Kampi/ZigBee-LightSensor/project/BeeLight.kicad_pcb

## KiCad design project/BeeLight.kicad_pcb (2025-01-14)

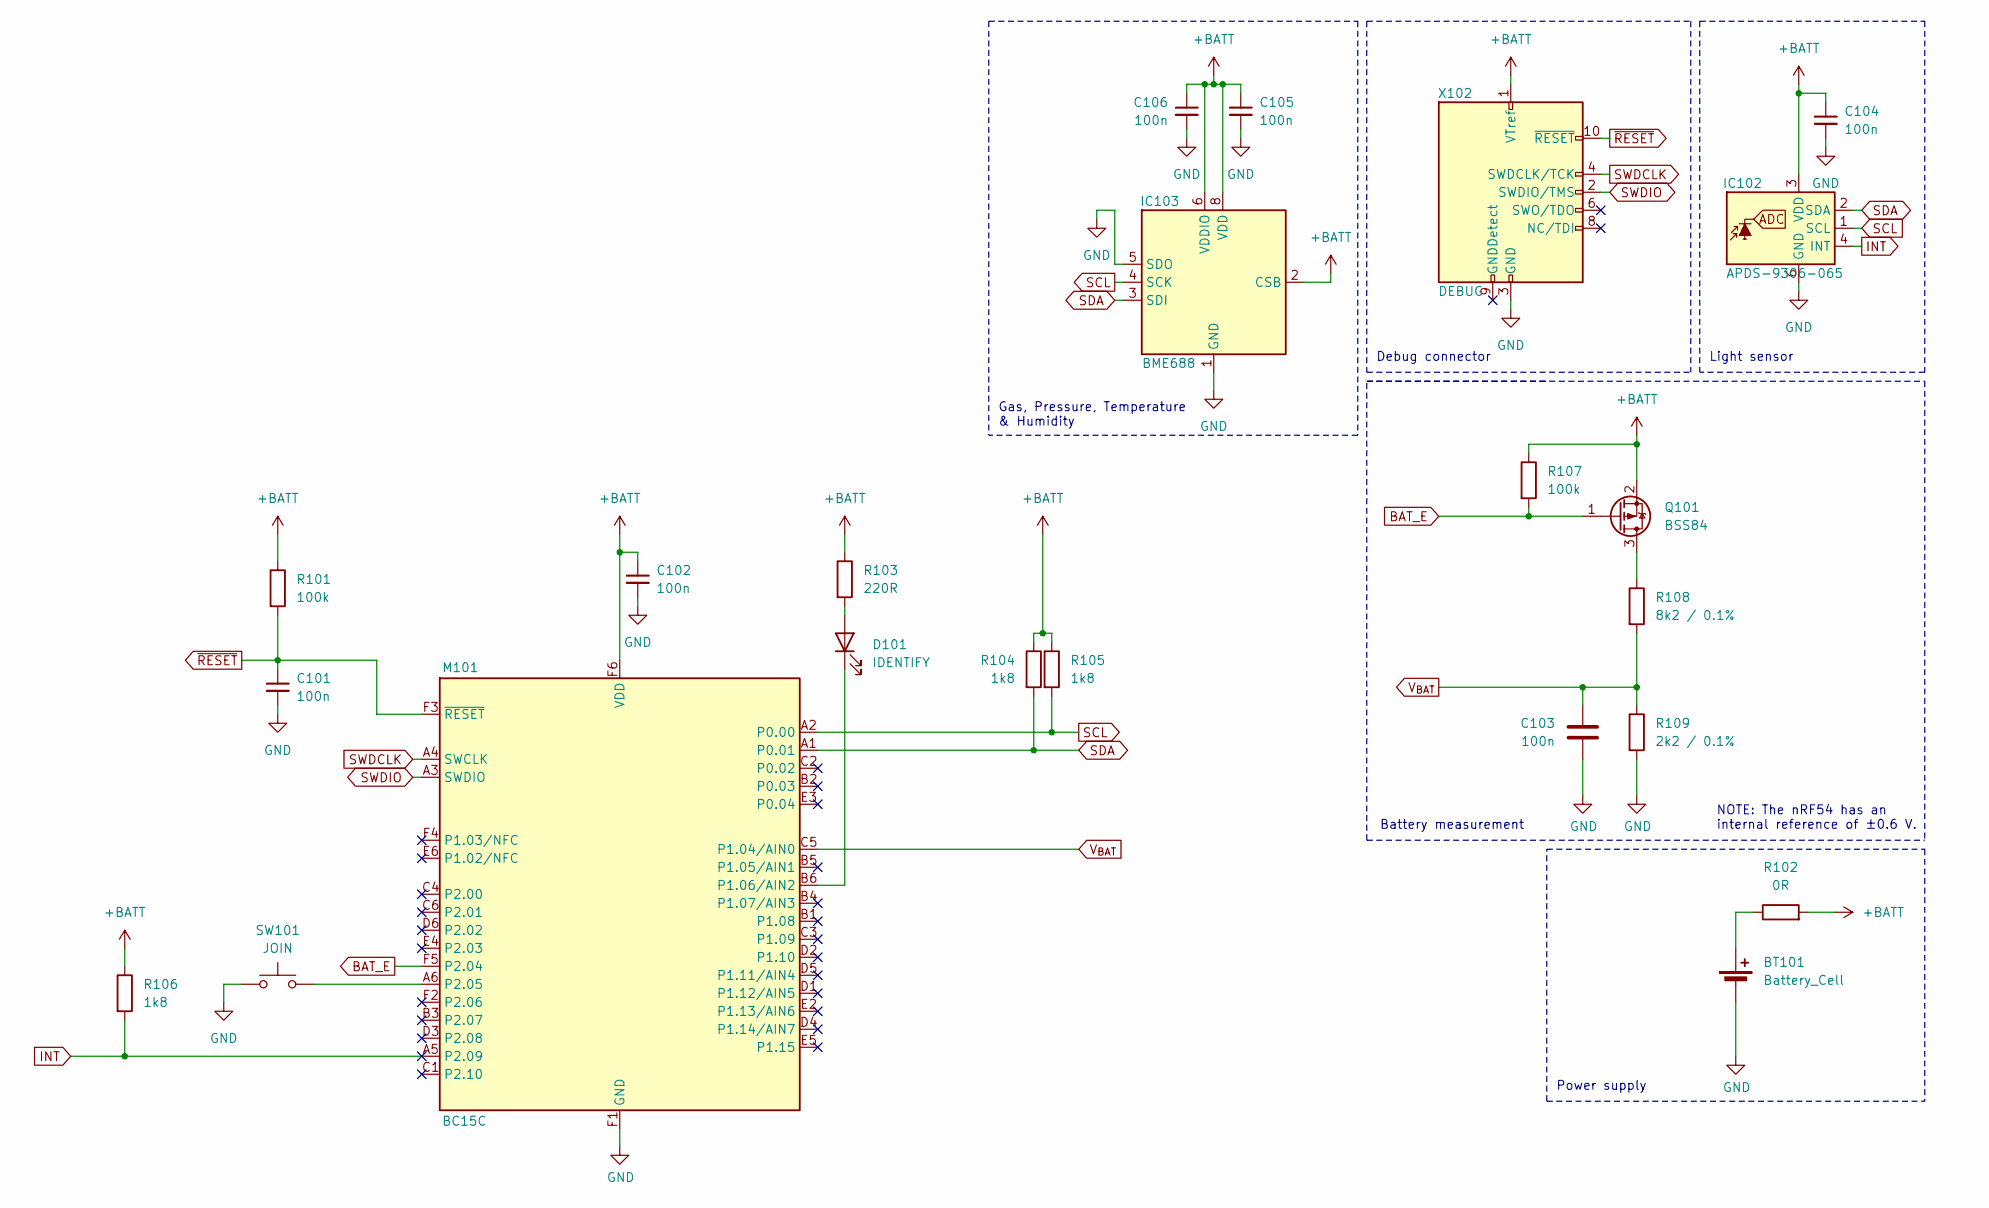
[picture p1: schematic BeeLight.kicad_sch]

Parts:
BT101: Battery_Cell; 3002; mouser# 534-3002
C101, C102, C103, C104, C105, C106: 100n; C_0402_1005Metric_Pad0.74x0.62mm_HandSolder; mouser# 581-04025C104KAT4A
D101: IDENTIFY; LED_0805_2012Metric_Pad1.15x1.40mm_HandSolder; mouser# 630-HSMQ-C170-T0000
IC102: APDS-9306-065; Broadcom_DFN-6_2x2mm_P0.65mm; mouser# 630-APDS-9306-065
IC103: BME688; Bosch_LGA-8_3x3mm_P0.8mm_ClockwisePinNumbering; mouser# 262-BME688
M101: BC15C; mouser# 308-BM15C
Q101: BSS84; SOT-23-3; mouser# 512-BSS84
R101, R107: 100k; R_0402_1005Metric_Pad0.72x0.64mm_HandSolder; mouser# 603-RC0402FR-07100KL
R102: 0R; R_0805_2012Metric_Pad1.20x1.40mm_HandSolder; mouser# 652-CR0805AJ/-000EAS
R103: 220R; R_0402_1005Metric_Pad0.72x0.64mm_HandSolder; mouser# 652-CR0402-JW-221GLF
R104, R105, R106: 1k8; R_0402_1005Metric_Pad0.72x0.64mm_HandSolder; mouser# 603-RC0402FR-071K8L
R108: 8k2 / 0.1%; R_0402_1005Metric_Pad0.72x0.64mm_HandSolder; mouser# 603-RT0402BRD078K2L
R109: 2k2 / 0.1%; R_0402_1005Metric_Pad0.72x0.64mm_HandSolder; mouser# 603-RT0402BRD072K2L
SW101: JOIN; WS-TASV-6x6; mouser# 710-430182095816
X102: DEBUG; PinHeader_2x05_P1.27mm_Vertical; mouser# 200-SHF-105-01-L-D-TH-TR

Connections:
+BATT: C102.1, C104.1, C105.1, C106.1, IC102.3 (VDD), IC103.2 (CSB), IC103.6 (VDDIO), IC103.8 (VDD), M101.F6 (VDD), Q101.2 (S), R101.1, R102.2, R103.1, R104.1, R105.1, R106.1, R107.1, X102.1 (VTref)
BAT_E: M101.F5 (P2.04), Q101.1 (G), R107.2
GND: BT101.2 (-), C101.2, C102.2, C103.2, C104.2, C105.2, C106.2, IC102.6 (GND), IC103.1 (GND), IC103.5 (SDO), IC103.7 (GND), M101.E1 (GND), M101.F1 (GND), R109.2, SW101.1, X102.3 (GND), X102.5 (GND)
INT: IC102.4 (INT), M101.A5 (P2.09), R106.2
unnamed: BT101.1 (+), R102.1
unnamed: D101.2 (A), R103.2
unnamed: D101.1 (K), M101.B6 (P1.06/AIN2)
unnamed: M101.A6 (P2.05), SW101.2
unnamed: Q101.3 (D), R108.1
SCL: IC102.1 (SCL), IC103.4 (SCK), M101.A2 (P0.00), R105.2
SDA: IC102.2 (SDA), IC103.3 (SDI), M101.A1 (P0.01), R104.2
SWDCLK: M101.A4 (SWCLK), X102.4 (SWDCLK/TCK)
SWDIO: M101.A3 (SWDIO), X102.2 (SWDIO/TMS)
V_{BAT}: C103.1, M101.C5 (P1.04/AIN0), R108.2, R109.1
~RESET: C101.1, M101.F3 (~RESET), R101.2, X102.10 (~RESET)

Notes on the sheet:
Debug connector
Gas, Pressure, Temperature & Humidity
NOTE: The nRF54 has an internal reference of ±0.6 V.
Light sensor
Battery measurement
Power supply

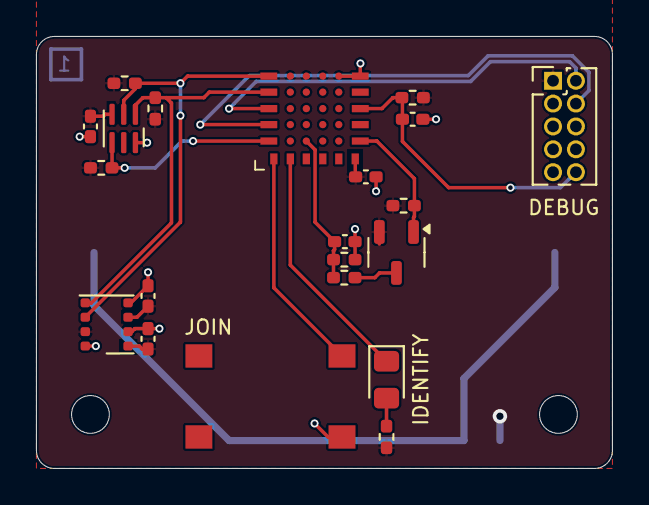
[picture p2: board BeeLight.kicad_pcb from above]

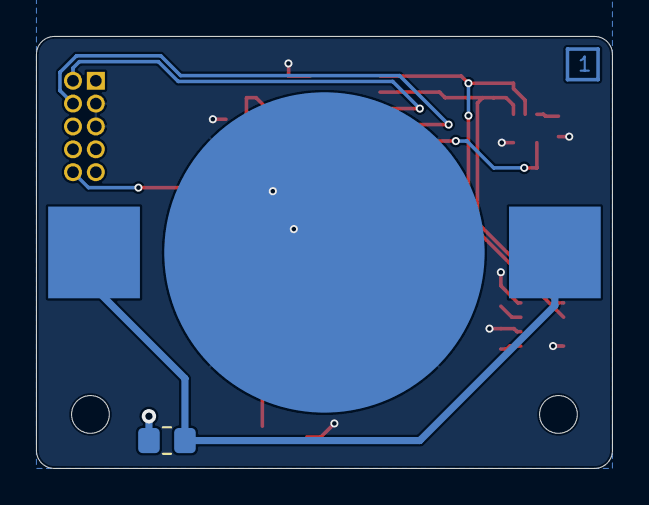
[picture p3: board BeeLight.kicad_pcb from below]

Board: 2 copper layers, 32.0 x 24.0 mm, 23 parts (2 on the bottom side), 15 nets.
